sampidevkit/ACIM-Debugger/V0/Production/V0.1/Pic/Top 3.png

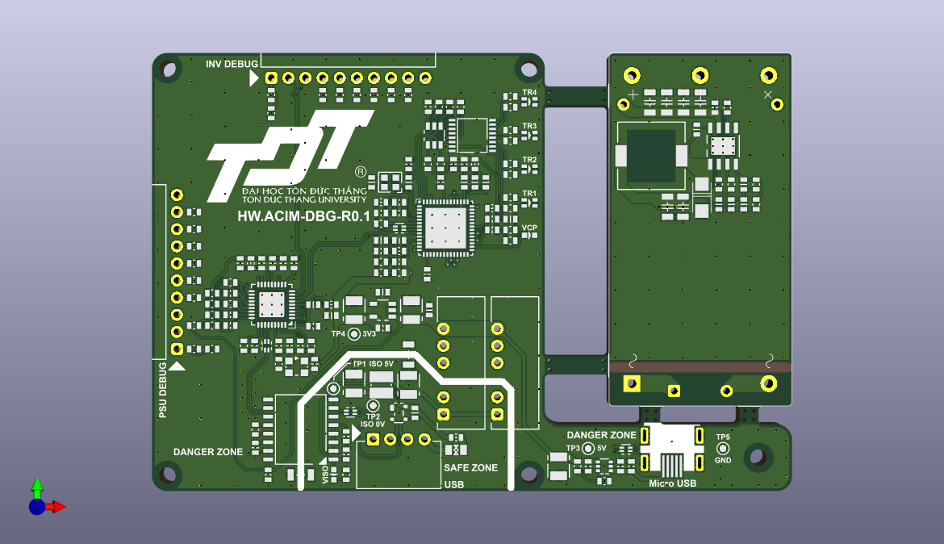
V0/Production/V0.1/Pic/Top 3.png
