sampidevkit/ACIM-Debugger/V0/Production/V0.1/Pic/Top 1.png

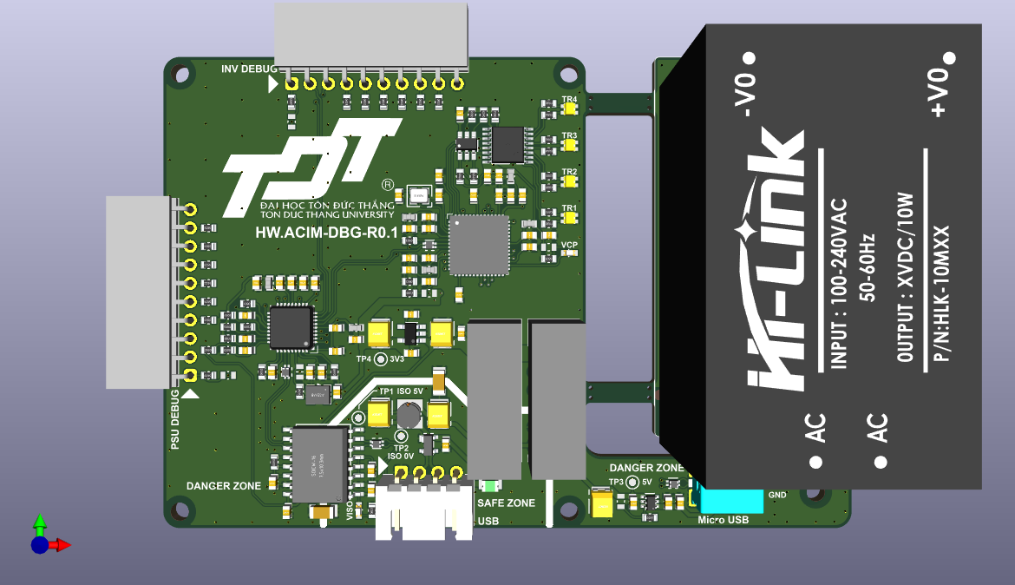
V0/Production/V0.1/Pic/Top 1.png
