sampidevkit/ACIM-Debugger/V0/Docs/RefDocs.md

# REFERENCE DOCUMENTS

1. [DM320106 - PIC32MK GP DEVELOPMENT KIT](https://www.microchip.com/en-us/development-tool/dm320106).

2. [FT4232H - QUAD HIGH SPEED USB TO MULTIPURPOSE UART/MPSSE IC Datasheet](https://ftdichip.com/wp-content/uploads/2020/08/DS_FT4232H.pdf).

3. [ADuM3160 - Full/Low Speed 2.5 kV USB Digital Isolator Datasheet](https://www.analog.com/media/en/technical-documentation/data-sheets/ADuM3160.pdf).

4. [UG-043 - EVAL-ADuM4160EBZ User Guide](https://www.analog.com/media/en/technical-documentation/user-guides/eval-adum4160ebz-ug-043.pdf).

5. [MPLAB Snap In-Circuit Debugger User's Guide](https://ww1.microchip.com/downloads/aemDocuments/documents/DEV/ProductDocuments/UserGuides/50002787C.pdf).

6. [USB251xB/xBi - USB 2.0 Hi-Speed Hub Controller Datasheet](https://ww1.microchip.com/downloads/aemDocuments/documents/UNG/ProductDocuments/DataSheets/USB251xB-xBi-Data-Sheet-DS00001692.pdf).

7. [EV96B94A - WBZ451 Curiosity Board User's Guide](https://ww1.microchip.com/downloads/aemDocuments/documents/WSG/ProductDocuments/UserGuides/WBZ451-Curiosity-Board-User-Guide-DS50003367.pdf).
