sampidevkit/ACIM-Debugger/V0/Production/V0.1/Pic/Bot.png

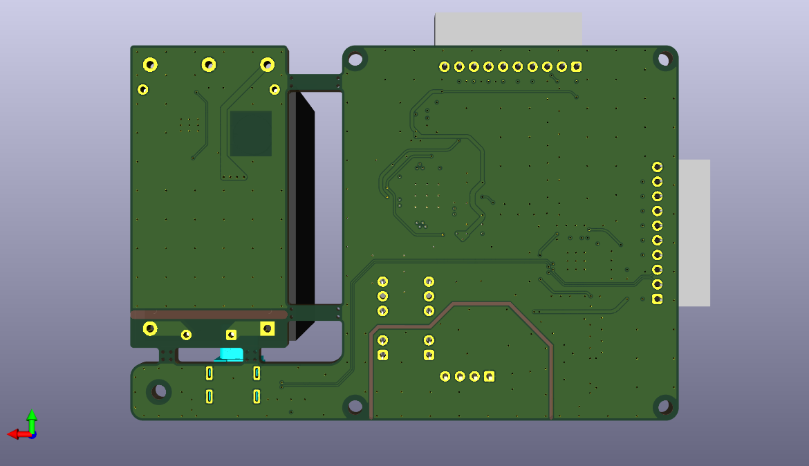
V0/Production/V0.1/Pic/Bot.png
