sampidevkit/ACIM-Debugger/V0/Production/V0.1/BoM/HW.ACIM-DBG.xlsx

# | MNP | MFT | Description | Reference | Qty | Stock Link
33 | ADUM3160BRWZ-RL | Analog | DGT ISOL 2500VRMS 2CH USB 16SOIC | U3 | 1
24 | DMN2310U-7 | Diodes | MOSFET N-CH 20 V 1.6A SOT-23-3 | Q1,Q2 | 2
21 | MCL2012V1-4R7-R | Eaton | FIXED IND 4.7UH 120MA 400MOHM SM | L1 | 1
35 | FT4232H-56Q | FTDI | IC USB TO UART/MPSSE QUAD 56VQFN | U5 | 1
9 | B2612USNG20D000212U1930 | Harvatek | LED GREEN/RED DIFFUSED 0606 SMD | D2 | 1
10 | B2612USNG20D000212U1930 | Harvatek | LED GREEN/RED DIFFUSED 0606 SMD | D3 | 1
11 | B2612USNG20D000212U1930 | Harvatek | LED GREEN/RED DIFFUSED 0606 SMD | D4 | 1
12 | B2612USNG20D000212U1930 | Harvatek | LED GREEN/RED DIFFUSED 0606 SMD | D5 | 1
13 | B1931TW--20P000314U1930 | Harvatek | LED WHITE 0603 SMD | D6 | 1
18 | ZX60-B-5S(31) | Hirose | CONN PLUG USB2.0 MICRO B SMD R/A | J2 | 1
16 | MCM1012B121F06BPDG | INPAQ | CMF 1210 120OHM 300MA 2LN SMD | FT2,FT3,FT6,FT11 | 4
1 | TLJB227M006R0500 | KAVX | CAP TANT 220UF 20% 6.3V 1411 | C1,C2,C7 | 3
14 | 0805L050WR | Littelfuse | PTC RESET FUSE 6V 500MA 0805 | F1 | 1
23 | PG164100 | MCHP | MPLAB SNAP DEBUGGER | MD2 | 1
31 | MIC5504-3.3YM5-TR | MCHP | IC REG LINEAR 3.3V 300MA SOT23-5 | U1 | 1
32 | USB2514B/M2 | MCHP | IC HUB CTLR 4PORT USB 2.0 HS 36S | U2 | 1
34 | DSC1001CE1-024.0000 | MCHP | MEMS OSC XO 24.0000MHZ CMOS SMD | U4 | 1
36 | 93LC56AT-I/OT | MCHP | IC EEPROM 2KBIT MIC WIRE SOT23-6 | U6 | 1
38 | DSC1001CE1-012.0000 | MCHP | MEMS OSC XO 12.0000MHZ CMOS SMD | U8 | 1
22 | B0505MT-1WR4 | Mornsun | DC DC CONVERTER 5V 1W | MD1 | 1
8 | PRTR5V0U2X,215 | Nexperia | TVS DIODE 5.5VWM SOT143B | D1 | 1
37 | 74HC595PW,118 | Nexperia | IC SHIFT REGISTER 8BIT 16TSSOP | U7 | 1
7 | JACK-USBC-4P | OEM | JACK USB TYPE C TO XH4-2.54 | CB1 | 1 | https://nshopvn.com/product/jack-type-c-4-day-co-nap-chong-nuoc/
20 | XH2.54-4P-R | OEM | PIN HEADER R/A 1x4POS 2.54MM | J4 | 1 | https://www.thegioiic.com/dau-xh-2-54mm-4-chan-cong-xuyen-lo
15 | PE-0603PFB121ST | Pulse | FERRITE BEAD 120 OHM 1A 0603 1LN | FT1,FT4,FT5,FT7,FT8,FT9,FT10 | 7
2 | CL10B104KB8NNNC | Samsung | CAP CER 0.1UF 50V X7R 0603 | C3,C4,C8,C11,C12,C15,C17,C19,C21,C22,C33,C35,C37,C39,C42,C45,C48,C49,C50,C51,C52 | 21
4 | CL10A106MQ8NNNC | Samsung | CAP CER 10UF 6.3V X5R 0603 | C9,C10,C13,C16,C26,C36,C40,C43,C46 | 9
17 | PPTC101LGBN-RC | Sullins | CONN HDR 10POS 0.1 TIN PCB R/A | J1 | 1
19 | PPTC101LGBN-RC | Sullins | CONN HDR 10POS 0.1 TIN PCB R/A | J3 | 1
5 | 0603N220J500CT | Walsin | CAP CER 22PF 50V C0G/NP0 0603 | C14,C18,C24,C25,C32,C34,C38,C41,C44,C47 | 10
3 | 885342208022 | WE | CAP CER 100PF 2000V X7R 1206 | C5,C6 | 2
6 | CC0603KRX7R9BB103 | YAGEO | CAP CER 10000PF 50V X7R 0603 | C20,C23,C27,C28,C29,C30,C31,C53 | 8
25 | AC0603FR-071K1L | YAGEO | RES SMD 1.1K OHM 1% 1/10W 0603 | R1,R35,R36,R37,R38,R39,R40,R41,R42 | 9
26 | RC0603JR-070RL | YAGEO | RES 0 OHM JUMPER 1/10W 0603 | R2,R8,R15,R17,R18,R19,R20,R21,R22,R23,R24,R25,R26,R27,R28,R43,R44,R45 | 18
27 | RC0603FR-0710KL | YAGEO | RES 10K OHM 1% 1/10W 0603 | R3,R4,R5,R6,R7,R30,R31,R32,R33,R34 | 10
28 | RC0603FR-0712KL | YAGEO | RES 12K OHM 1% 1/10W 0603 | R9,R29 | 2
29 | RC0603FR-0747KL | YAGEO | RES 47K OHM 1% 1/10W 0603 | R10,R11,R12 | 3
30 | RC0603FR-07100KL | YAGEO | RES 100K OHM 1% 1/10W 0603 | R13,R14,R16 | 3
