sampidevkit/ACIM-Debugger/V0/Production/V0.1/Sch/HW.ACIM-DBG.pdf

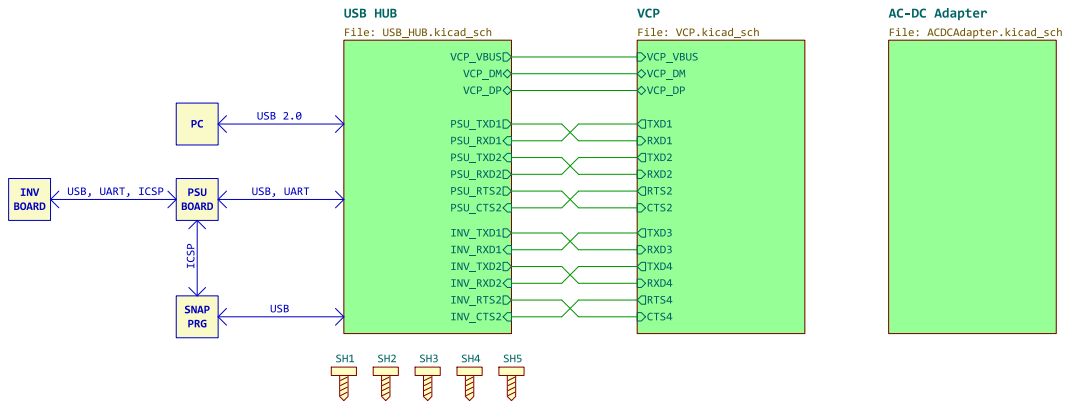
[picture p4: page 1]

Schematic Designed by ... PCB Designed by ... Approved by ...

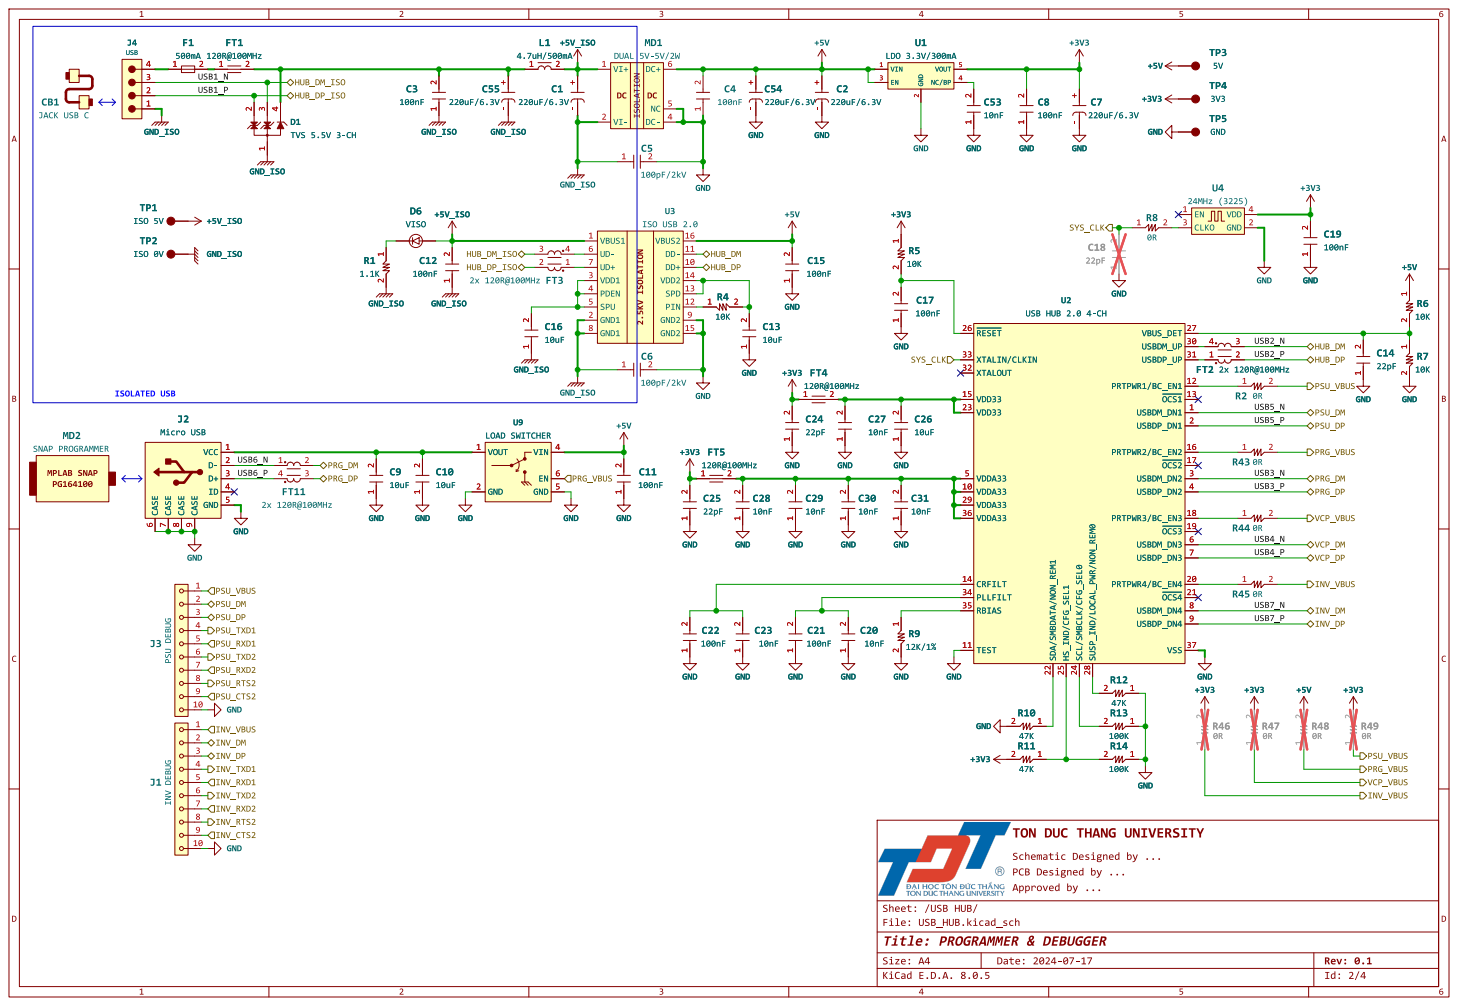
[picture p5: page 2]

2 EN 3 NC/BP 4 VOUT 5 U1
LDO3.3V/300mA

2 EN 3 NC/BP 4 VOUT 5 GND C54

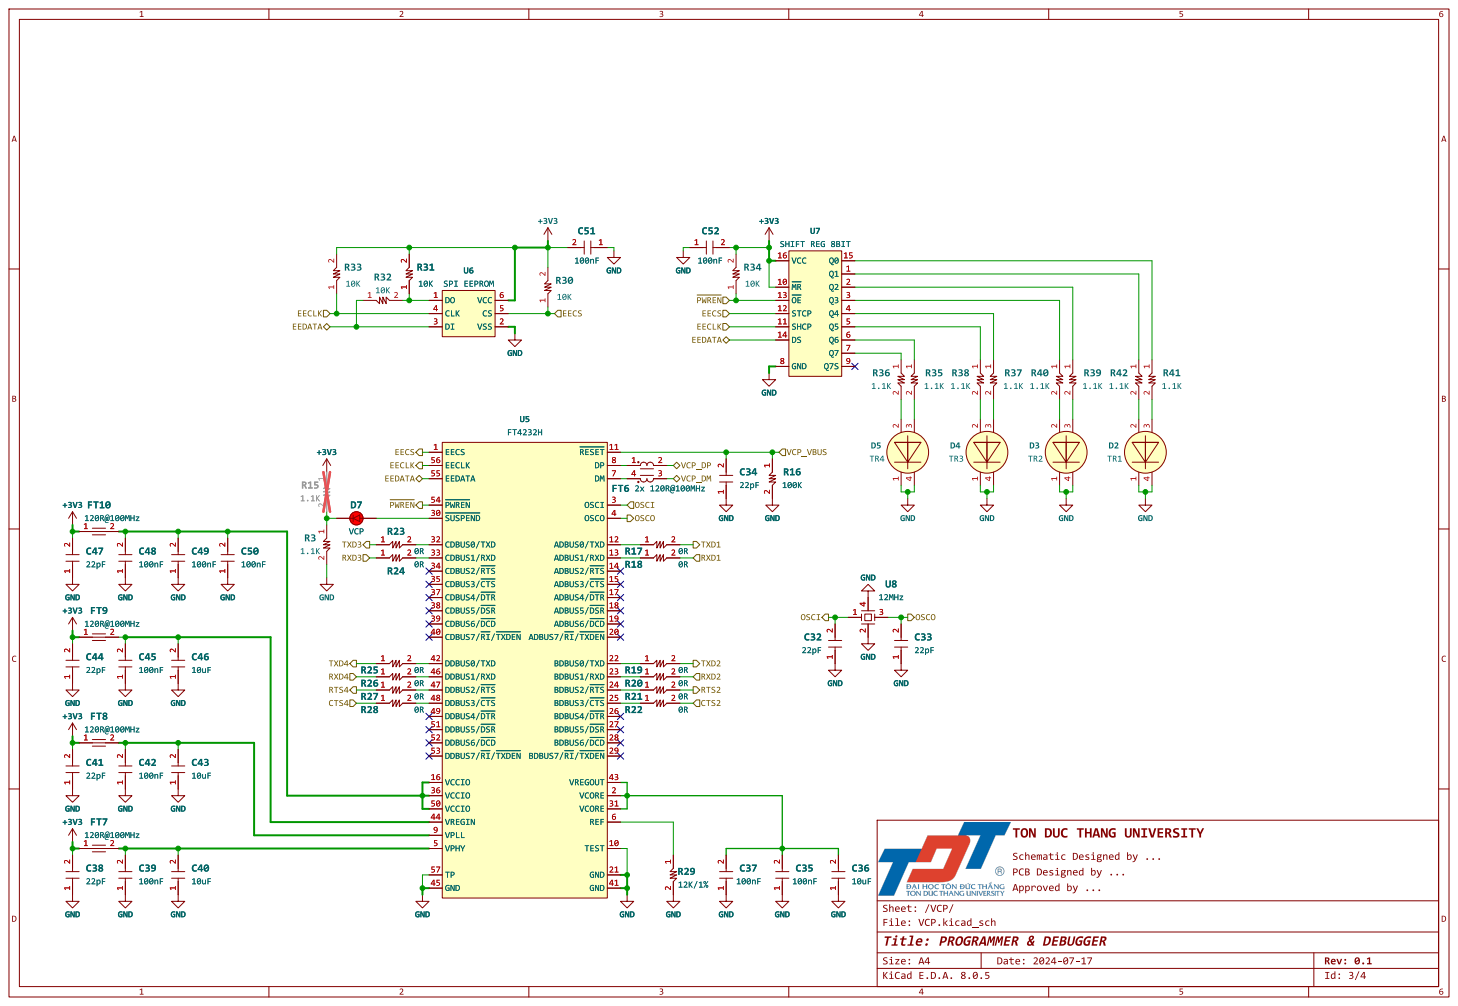
[picture p6: page 3]

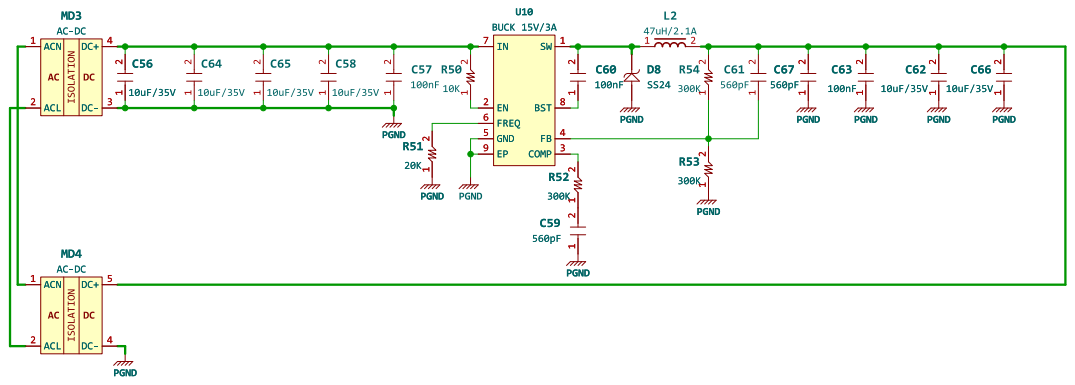
[picture p7: page 4]

Schematic Designed by ... PCB Designed by ... Approved by ...
