sampidevkit/ACIM-Debugger/V0/Production/V0.0/Sch/HW.ACIM-DBG.pdf

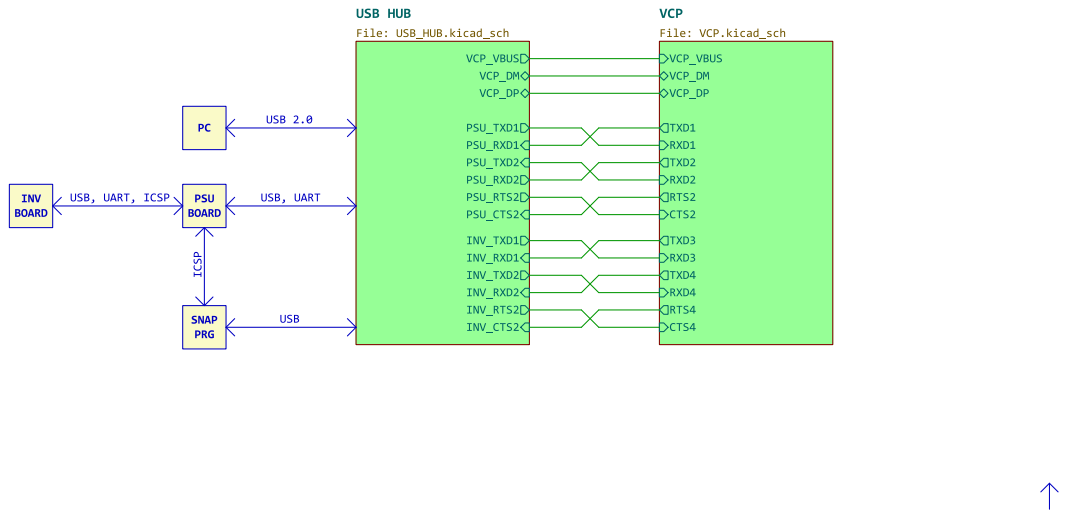
[picture p8: page 1]

Schematic Designed by ... PCB Designed by ... Approved by ...

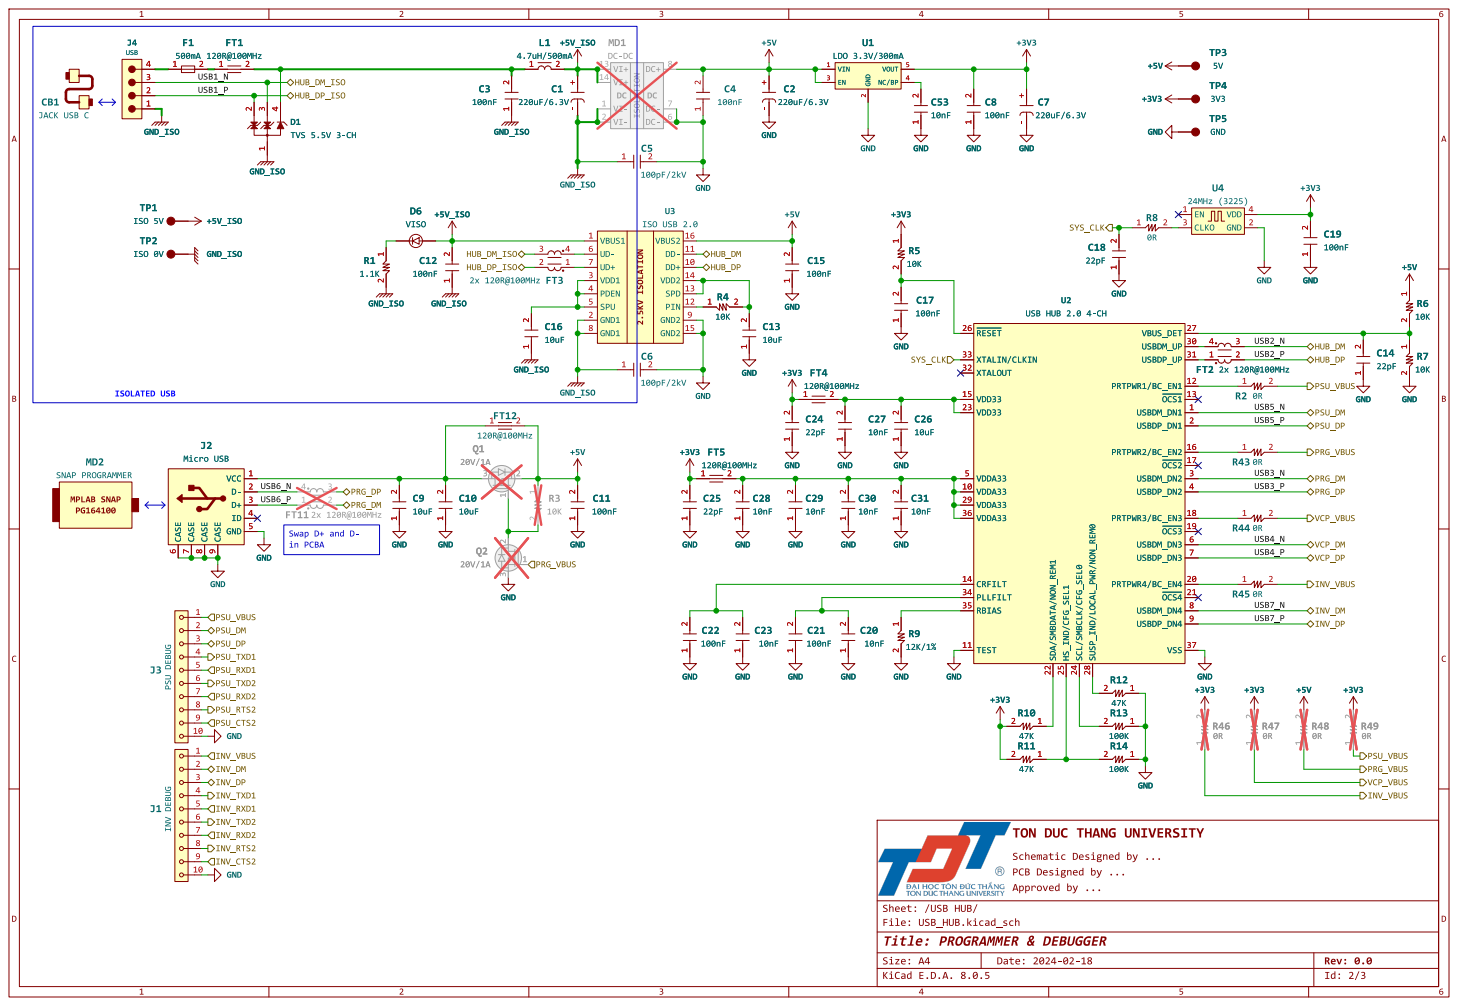
[picture p9: page 2]

2 EN 3 NC/BP 4 VOUT 5 U1
LDO3.3V/300mA GND

2 EN 3 NC/BP 4 VOUT 5R5

Schematic Designed by ... PCB Designed by ... Approved by ...

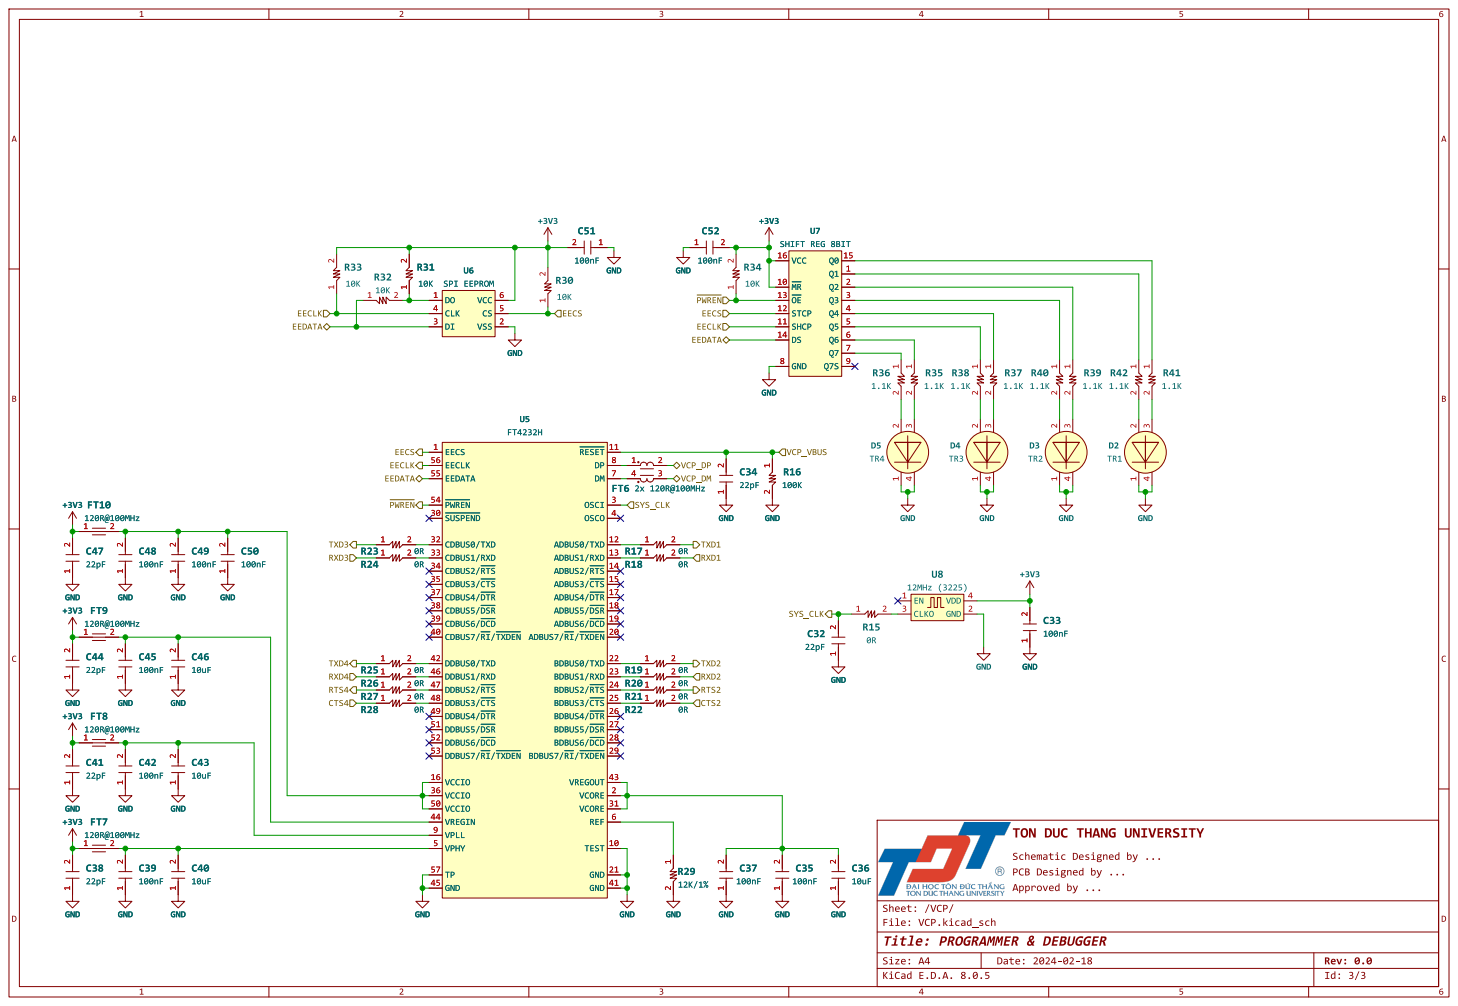
[picture p10: page 3]

3 4 D3 TR2 EN 1 GND 2 CLKO 3 VDD 4 U8
