sampidevkit/ACIM-Debugger/V0/Design/HW.ACIM-DBG/ACDCAdapter.kicad_sch

## KiCad design V0/Design/HW.ACIM-DBG/ACDCAdapter.kicad_sch (2024-09-26)

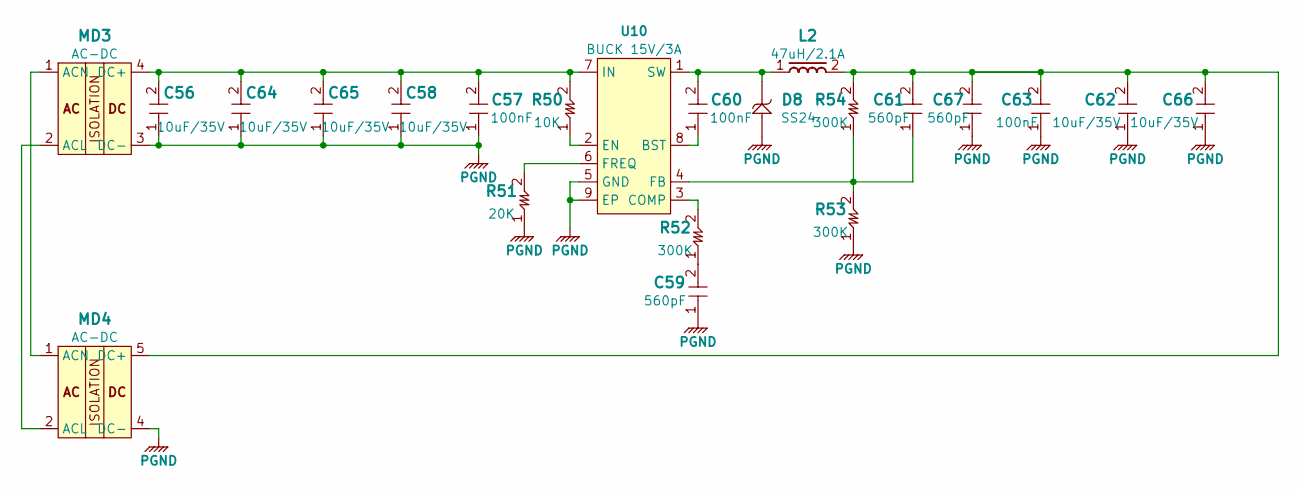
[picture p11: schematic ACDCAdapter.kicad_sch]

Parts:
C56, C58, C62, C64, C65, C66: 10uF/35V; CAP1206
C57, C60, C63: 100nF; CAP0603
C59, C61, C67: 560pF; CAP0603
D8: SS24; DO-214AC
L2: 47uH/2.1A; IND-10x10x3.8
MD3: AC-DC; HLK-10M
MD4: AC-DC; LD10-23BxxR2-RC
R50: 10K; RES0603
R51: 20K; RES0603
R52, R53, R54: 300K; RES0603
U10: BUCK 15V/3A; SOIC8E_3.9_MPS

Connections:
unnamed: C56.2, C57.2, C58.2, C64.2, C65.2, MD3.4 (DC+), R50.2, U10.7 (IN)
unnamed: C59.2, R52.1
unnamed: C60.1, U10.8 (BST)
unnamed: C60.2, D8.K, L2.1, U10.1 (SW)
unnamed: C61.1, R53.2, R54.1, U10.4 (FB)
unnamed: C61.2, C62.2, C63.2, C66.2, C67.2, L2.2, MD4.5 (DC+), R54.2
unnamed: MD3.1 (ACN), MD4.1 (ACN)
unnamed: MD3.2 (ACL), MD4.2 (ACL)
unnamed: R50.1, U10.2 (EN)
unnamed: R51.2, U10.6 (FREQ)
unnamed: R52.2, U10.3 (COMP)
PGND: C56.1, C57.1, C58.1, C59.1, C62.1, C63.1, C64.1, C65.1, C66.1, C67.1, D8.A, MD3.3 (DC-), MD4.4 (DC-), R51.1, R53.1, U10.5 (GND), U10.9 (EP)
