sampidevkit/ACIM-Debugger/V0/Design/HW.ACIM-DBG/HW.ACIM-DBG.kicad_sch

## KiCad design V0/Design/HW.ACIM-DBG/HW.ACIM-DBG.kicad_sch (2024-09-26)

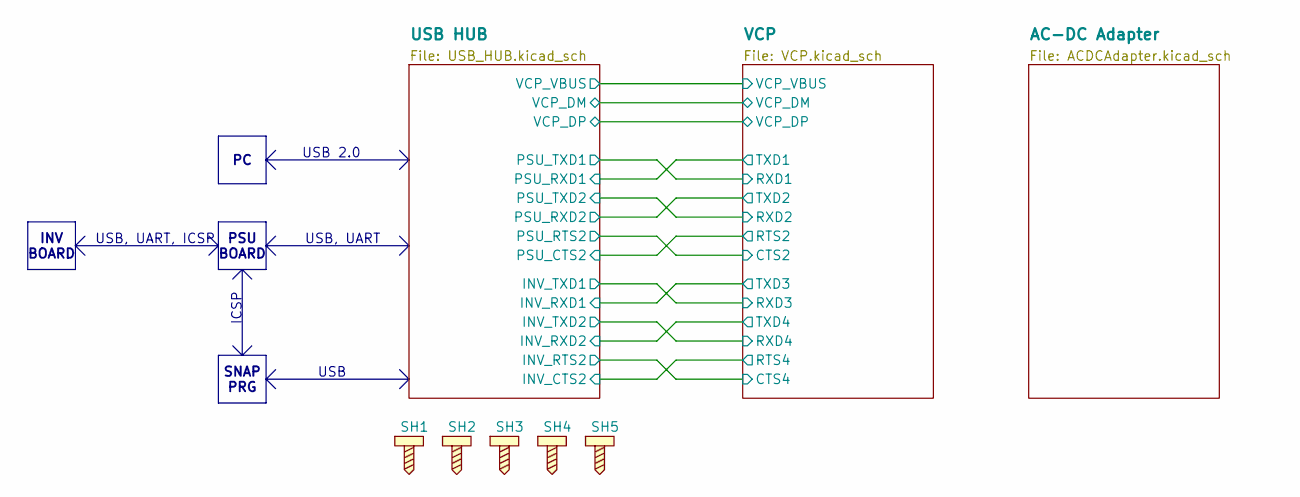
[picture p12: schematic HW.ACIM-DBG.kicad_sch]

Parts:
SH1, SH2, SH3, SH4, SH5: SCREW HOLDER; SCREWHOLE-2.5M

Notes on the sheet:
SNAP PRG
PSU BOARD
INV BOARD
USB
ICSP
USB, UART
USB, UART, ICSP
USB 2.0
