sampidevkit/ACIM-Debugger/V0/Design/HW.ACIM-DBG/USB_HUB.kicad_sch

## KiCad design V0/Design/HW.ACIM-DBG/USB_HUB.kicad_sch (2024-09-26)

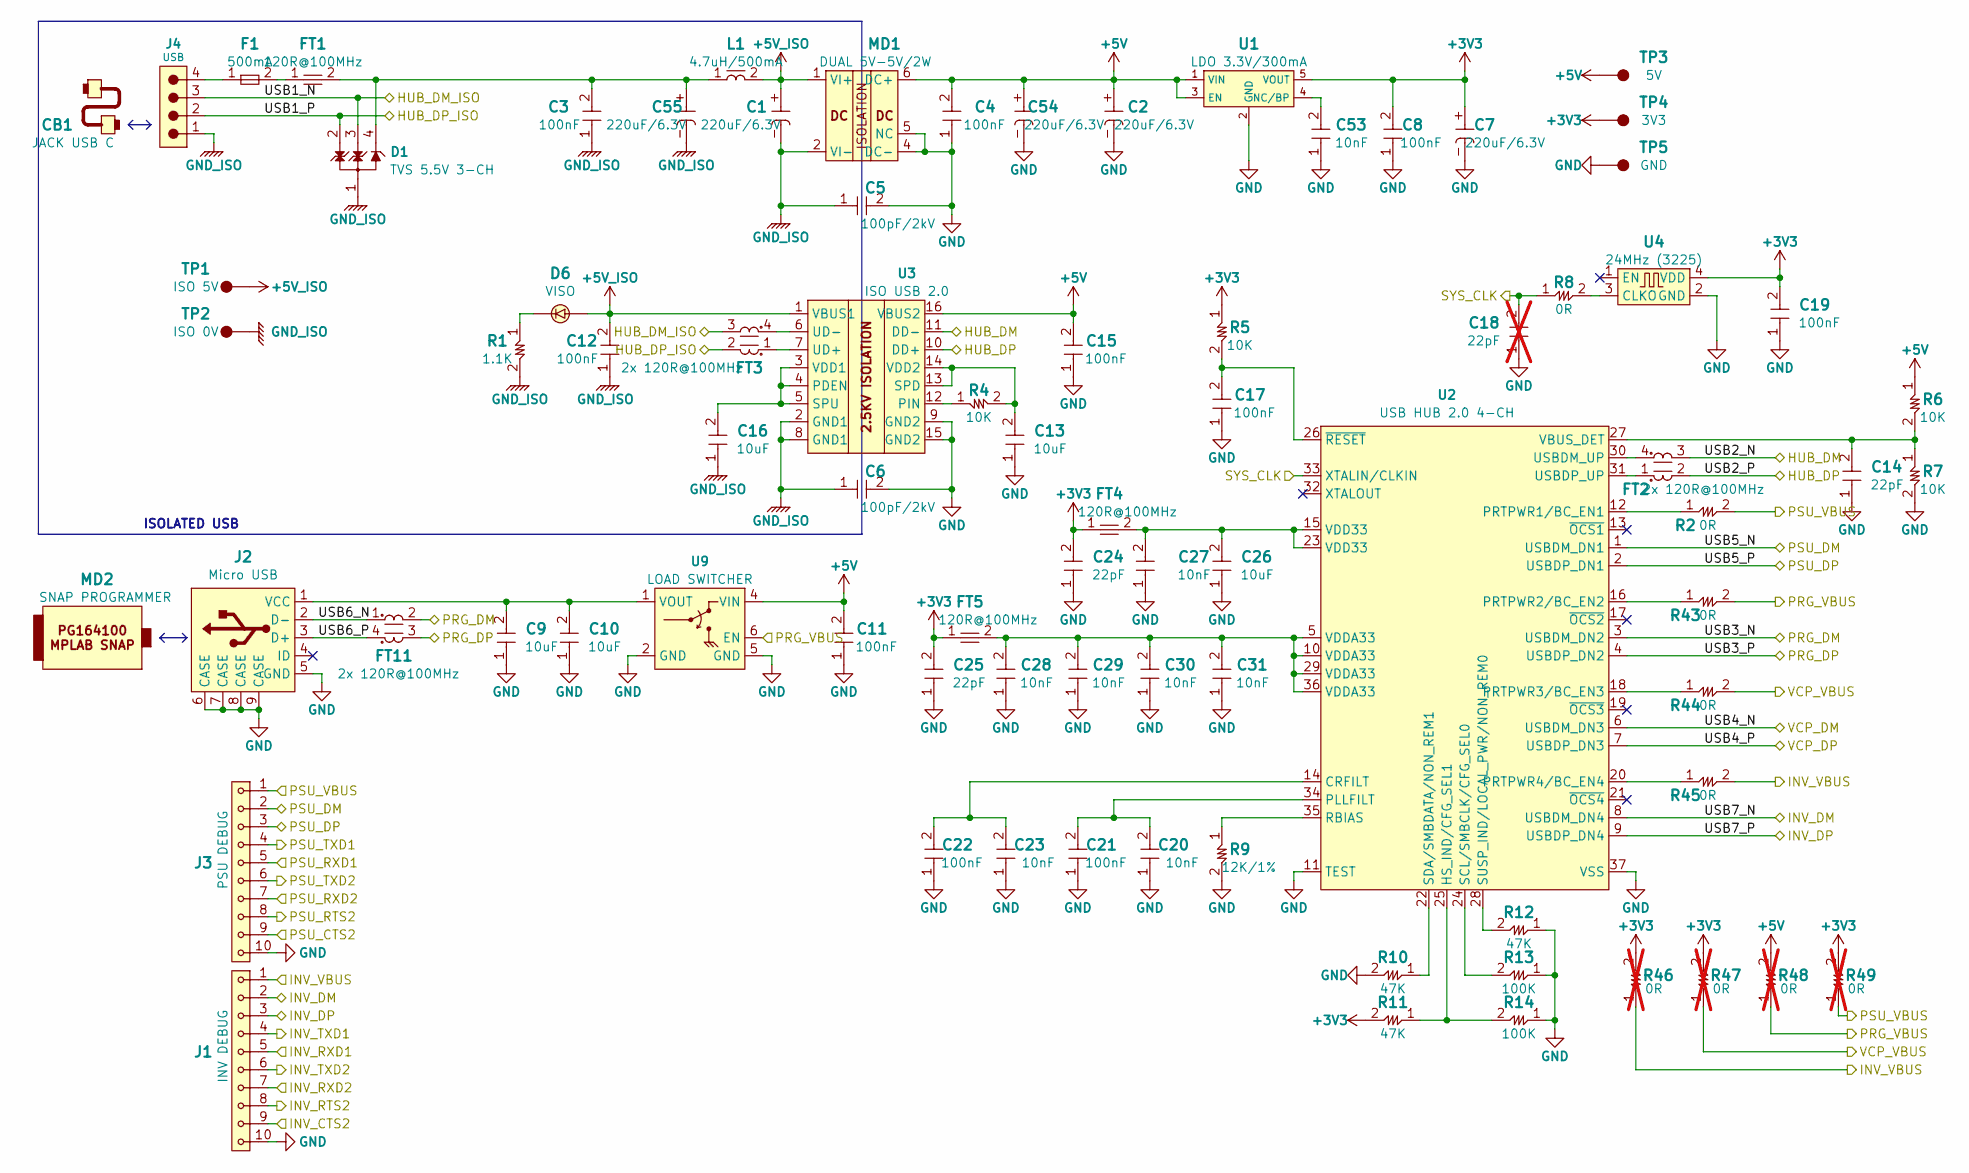
[picture p13: schematic USB_HUB.kicad_sch]

Parts:
C1, C2, C7, C54, C55: 220uF/6.3V; CAP1411
C3, C4, C8, C11, C12, C15, C17, C19, C21, C22: 100nF; CAP0603
C5, C6: 100pF/2kV; CAP1206
C9, C10, C13, C16, C26: 10uF; CAP0603
C14, C24, C25: 22pF; CAP0603
C18: 22pF; CAP0603; not fitted
C20, C23, C27, C28, C29, C30, C31, C53: 10nF; CAP0603
CB1: JACK USB C
D1: TVS 5.5V 3-CH; SOT143B_NEXT
D6: VISO; LED0603
F1: 500mA; FUSE0805
FT1, FT4, FT5: 120R@100MHz; FT0603
FT2, FT3, FT11: 2x 120R@100MHz; IND1210_4P
J1: INV DEBUG; HDF1x10x2.54_TH_RA
J2: Micro USB; ZX60-B-5S(31)
J3: PSU DEBUG; HDF1x10x2.54_TH_RA
J4: USB; HDM-1x4x2.54-TH-RA
L1: 4.7uH/500mA; IND3521
MD1: DUAL 5V-5V/2W; B0505S-2WR2-DUAL
MD2: SNAP PROGRAMMER
R1: 1.1K; RES0603
R2, R8, R43, R44, R45: 0R; RES0603
R4, R5, R6, R7: 10K; RES0603
R9: 12K/1%; RES0603
R10, R11, R12: 47K; RES0603
R13, R14: 100K; RES0603
R46, R47, R48, R49: 0R; RES0603; not fitted
TP1: ISO 5V; TP1MM
TP2: ISO 0V; TP1MM
TP3: 5V; TP1MM
TP4: 3V3; TP1MM
TP5: GND; TP1MM
U1: LDO 3.3V/300mA; SOT-23-5_MCHP
U2: USB HUB 2.0 4-CH; SQFN36_6x6_MCHP
U3: ISO USB 2.0; SOIC16_7.5_AN
U4: 24MHz (3225); CDFN3225-4LD-PL-1
U9: LOAD SWITCHER; SOT363

Connections:
+3V3: C7.+, C8.2, C19.2, C24.2, C25.2, FT4.1, FT5.1, R5.1, R11.2, R46.2, R47.2, R49.2, TP4.1, U1.5 (VOUT), U4.4 (VDD)
+5V: C2.+, C4.2, C11.2, C15.2, C54.+, MD1.6 (DC+), R6.1, R48.2, TP3.1, U1.1 (VIN), U1.3 (EN), U3.16 (VBUS2), U9.4 (VIN)
+5V_ISO: C1.+, C12.2, D6.A, L1.2, MD1.1 (VI+), TP1.1, U3.1 (VBUS1)
GND: C2.-, C4.1, C5.2, C6.2, C7.-, C8.1, C9.1, C10.1, C11.1, C13.1, C14.1, C15.1, C17.1, C18.1, C19.1, C20.1, C21.1, C22.1, C23.1, C24.1, C25.1, C26.1, C27.1, C28.1, C29.1, C30.1, C31.1, C53.1, C54.-, J1.10, J2.5 (GND), J2.6 (CASE), J2.7 (CASE), J2.8 (CASE), J2.9 (CASE), J3.10, MD1.4 (DC-), MD1.5 (NC), R7.2, R9.2, R10.2, R12.1, R13.1, R14.1, TP5.1, U1.2 (GND), U2.11 (TEST), U2.37 (VSS), U3.9 (GND2), U3.15 (GND2), U4.2 (GND), U9.2 (GND), U9.5 (GND)
GND_ISO: C1.-, C3.1, C5.1, C6.1, C12.1, C16.1, C55.-, D1.1 (GND), J4.1, MD1.2 (VI-), R1.2, TP2.1, U3.2 (GND1), U3.8 (GND1)
HUB_DM: FT2.3, U3.11 (DD-)
HUB_DM_ISO: D1.3 (CH2), FT3.3, J4.3
HUB_DP: FT2.2, U3.10 (DD+)
HUB_DP_ISO: D1.2 (CH1), FT3.2, J4.2
INV_CTS2: J1.9
INV_DM: J1.2, U2.8 (USBDM_DN4)
INV_DP: J1.3, U2.9 (USBDP_DN4)
INV_RTS2: J1.8
INV_RXD1: J1.5
INV_RXD2: J1.7
INV_TXD1: J1.4
INV_TXD2: J1.6
INV_VBUS: J1.1, R45.2, R46.1
unnamed: C3.2, C55.+, D1.4 (CH3), FT1.2, L1.1
unnamed: C9.2, C10.2, J2.1 (VCC), U9.1 (VOUT)
unnamed: C13.2, R4.2, U3.13 (SPD), U3.14 (VDD2)
unnamed: C14.2, R6.2, R7.1, U2.27 (VBUS_DET)
unnamed: C16.2, U3.3 (VDD1), U3.4 (PDEN), U3.5 (SPU)
unnamed: C17.2, R5.2, U2.26 (~RESET)
unnamed: C20.2, C21.2, U2.34 (PLLFILT)
unnamed: C22.2, C23.2, U2.14 (CRFILT)
unnamed: C26.2, C27.2, FT4.2, U2.15 (VDD33), U2.23 (VDD33)
unnamed: C28.2, C29.2, C30.2, C31.2, FT5.2, U2.5 (VDDA33), U2.10 (VDDA33), U2.29 (VDDA33), U2.36 (VDDA33)
unnamed: C53.2, U1.4 (NC/BP)
unnamed: D6.K, R1.1
unnamed: F1.1, J4.4
unnamed: F1.2, FT1.1
unnamed: FT2.1, U2.31 (USBDP_UP)
unnamed: FT2.4, U2.30 (USBDM_UP)
unnamed: FT3.1, U3.7 (UD+)
unnamed: FT3.4, U3.6 (UD-)
unnamed: R2.1, U2.12 (PRTPWR1/BC_EN1)
unnamed: R4.1, U3.12 (PIN)
unnamed: R8.2, U4.3 (CLKO)
unnamed: R9.1, U2.35 (RBIAS)
unnamed: R10.1, U2.22 (SDA/SMBDATA/NON_REM1)
unnamed: R11.1, R14.2, U2.25 (HS_IND/CFG_SEL1)
unnamed: R12.2, U2.28 (SUSP_IND/LOCAL_PWR/NON_REM0)
unnamed: R13.2, U2.24 (SCL/SMBCLK/CFG_SEL0)
unnamed: R43.1, U2.16 (PRTPWR2/BC_EN2)
unnamed: R44.1, U2.18 (PRTPWR3/BC_EN3)
unnamed: R45.1, U2.20 (PRTPWR4/BC_EN4)
PRG_DM: FT11.2, U2.3 (USBDM_DN2)
PRG_DP: FT11.3, U2.4 (USBDP_DN2)
PRG_VBUS: R43.2, R48.1, U9.6 (EN)
PSU_CTS2: J3.9
PSU_DM: J3.2, U2.1 (USBDM_DN1)
PSU_DP: J3.3, U2.2 (USBDP_DN1)
PSU_RTS2: J3.8
PSU_RXD1: J3.5
PSU_RXD2: J3.7
PSU_TXD1: J3.4
PSU_TXD2: J3.6
PSU_VBUS: J3.1, R2.2, R49.1
SYS_CLK: C18.2, R8.1, U2.33 (XTALIN/CLKIN)
USB4_N: U2.6 (USBDM_DN3)
USB4_P: U2.7 (USBDP_DN3)
USB6_N: FT11.1, J2.2 (D-)
USB6_P: FT11.4, J2.3 (D+)
VCP_VBUS: R44.2, R47.1

Notes on the sheet:
ISOLATED USB
