sampidevkit/ACIM-Debugger/V0/Design/HW.ACIM-DBG/VCP.kicad_sch

## KiCad design V0/Design/HW.ACIM-DBG/VCP.kicad_sch (2024-09-26)

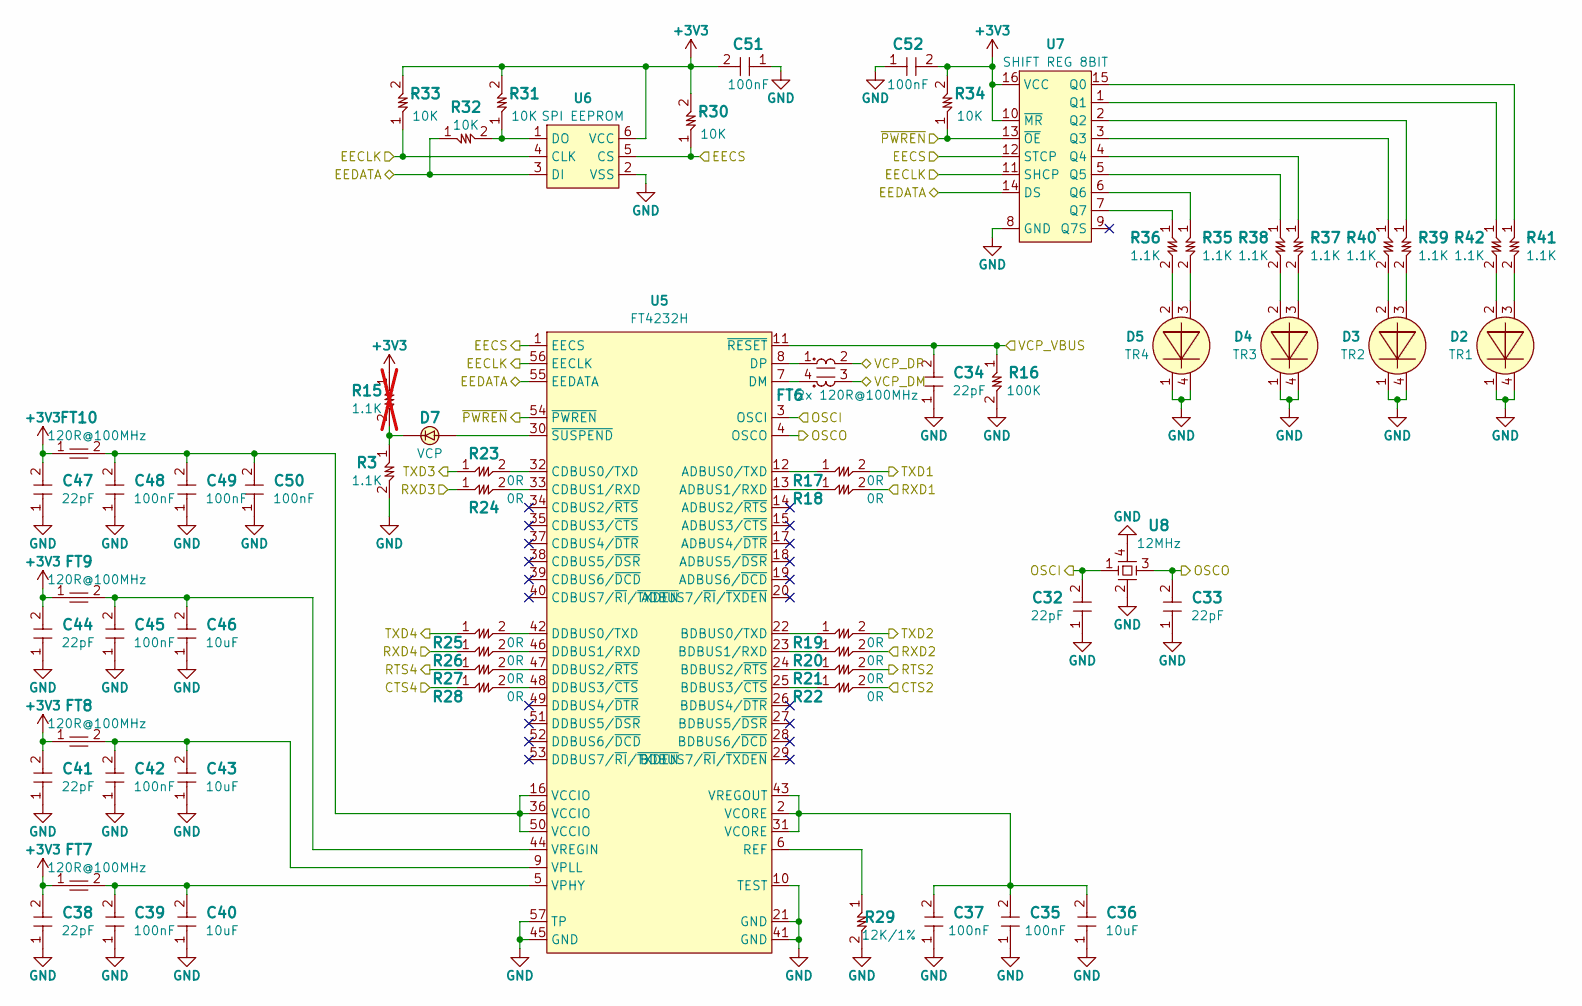
[picture p14: schematic VCP.kicad_sch]

Parts:
C32, C33, C34, C38, C41, C44, C47: 22pF; CAP0603
C35, C37, C39, C42, C45, C48, C49, C50, C51, C52: 100nF; CAP0603
C36, C40, C43, C46: 10uF; CAP0603
D2: TR1; LED0606_4P
D3: TR2; LED0606_4P
D4: TR3; LED0606_4P
D5: TR4; LED0606_4P
D7: VCP; LED0603
FT6: 2x 120R@100MHz; IND1210_4P
FT7, FT8, FT9, FT10: 120R@100MHz; FT0603
R3, R35, R36, R37, R38, R39, R40, R41, R42: 1.1K; RES0603
R15: 1.1K; RES0603; not fitted
R16: 100K; RES0603
R17, R18, R19, R20, R21, R22, R23, R24, R25, R26, R27, R28: 0R; RES0603
R29: 12K/1%; RES0603
R30, R31, R32, R33, R34: 10K; RES0603
U5: FT4232H; VQFN-56_FTDI
U6: SPI EEPROM; SOT-23-6_MCHP
U7: SHIFT REG 8BIT; TSSOP16-SOT403-1
U8: 12MHz; CDFN2520-ABM10

Connections:
+3V3: C38.2, C41.2, C44.2, C47.2, C51.2, C52.2, FT7.1, FT8.1, FT9.1, FT10.1, R15.1, R30.2, R31.2, R33.2, R34.2, U6.6 (VCC), U7.10 (~MR), U7.16 (VCC)
CTS2: R22.2
CTS4: R28.1
EECLK: R33.1, U5.56 (EECLK), U6.4 (CLK), U7.11 (SHCP)
EECS: R30.1, U5.1 (EECS), U6.5 (CS), U7.12 (STCP)
EEDATA: R32.1, U5.55 (EEDATA), U6.3 (DI), U7.14 (DS)
GND: C32.1, C33.1, C34.1, C35.1, C36.1, C37.1, C38.1, C39.1, C40.1, C41.1, C42.1, C43.1, C44.1, C45.1, C46.1, C47.1, C48.1, C49.1, C50.1, C51.1, C52.1, D2.1 (GK), D2.4 (RK), D3.1 (GK), D3.4 (RK), D4.1 (GK), D4.4 (RK), D5.1 (GK), D5.4 (RK), R3.2, R16.2, R29.2, U5.10 (TEST), U5.21 (GND), U5.41 (GND), U5.45 (GND), U5.57 (TP), U6.2 (VSS), U7.8 (GND), U8.2 (GND1), U8.4 (X2)
unnamed: C35.2, C36.2, C37.2, U5.2 (VCORE), U5.31 (VCORE), U5.43 (VREGOUT)
unnamed: C39.2, C40.2, FT7.2, U5.5 (VPHY)
unnamed: C42.2, C43.2, FT8.2, U5.9 (VPLL)
unnamed: C45.2, C46.2, FT9.2, U5.44 (VREGIN)
unnamed: C48.2, C49.2, C50.2, FT10.2, U5.16 (VCCIO), U5.36 (VCCIO), U5.50 (VCCIO)
unnamed: D2.2 (GA), R42.2
unnamed: D2.3 (RA), R41.2
unnamed: D3.2 (GA), R40.2
unnamed: D3.3 (RA), R39.2
unnamed: D4.2 (GA), R38.2
unnamed: D4.3 (RA), R37.2
unnamed: D5.2 (GA), R36.2
unnamed: D5.3 (RA), R35.2
unnamed: D7.A, U5.30 (~SUSPEND)
unnamed: D7.K, R3.1, R15.2
unnamed: FT6.1, U5.8 (DP)
unnamed: FT6.4, U5.7 (DM)
unnamed: R17.1, U5.12 (ADBUS0/TXD)
unnamed: R18.1, U5.13 (ADBUS1/RXD)
unnamed: R19.1, U5.22 (BDBUS0/TXD)
unnamed: R20.1, U5.23 (BDBUS1/RXD)
unnamed: R21.1, U5.24 (BDBUS2/~RTS)
unnamed: R22.1, U5.25 (BDBUS3/~CTS)
unnamed: R23.2, U5.32 (CDBUS0/TXD)
unnamed: R24.2, U5.33 (CDBUS1/RXD)
unnamed: R25.2, U5.42 (DDBUS0/TXD)
unnamed: R26.2, U5.46 (DDBUS1/RXD)
unnamed: R27.2, U5.47 (DDBUS2/~RTS)
unnamed: R28.2, U5.48 (DDBUS3/~CTS)
unnamed: R29.1, U5.6 (REF)
unnamed: R31.1, R32.2, U6.1 (DO)
unnamed: R35.1, U7.6 (Q6)
unnamed: R36.1, U7.7 (Q7)
unnamed: R37.1, U7.4 (Q4)
unnamed: R38.1, U7.5 (Q5)
unnamed: R39.1, U7.2 (Q2)
unnamed: R40.1, U7.3 (Q3)
unnamed: R41.1, U7.15 (Q0)
unnamed: R42.1, U7.1 (Q1)
OSCI: C32.2, U5.3 (OSCI), U8.1 (X1)
OSCO: C33.2, U5.4 (OSCO), U8.3 (GND2)
RTS2: R21.2
RTS4: R27.1
RXD1: R18.2
RXD2: R20.2
RXD3: R24.1
RXD4: R26.1
TXD1: R17.2
TXD2: R19.2
TXD3: R23.1
TXD4: R25.1
VCP_DM: FT6.3
VCP_DP: FT6.2
VCP_VBUS: C34.2, R16.1, U5.11 (~RESET)
~PWREN: R34.1, U5.54 (~PWREN), U7.13 (~OE)
