sampidevkit/ACIM-Debugger/(commit log)

2024-09-25 V0 production files
    [HW.ACIM-DBG-B_Cu.gbr, HW.ACIM-DBG-B_Mask.gbr, HW.ACIM-DBG-B_Paste.gbr, HW.ACIM-DBG-B_Silkscreen.gbr, HW.ACIM-DBG-Edge_Cuts.gbr, HW.ACIM-DBG-F_Cu.gbr, HW.ACIM-DBG-F_Mask.gbr, HW.ACIM-DBG-F_Paste.gbr]
2024-09-26 V0.1 production files
    [ACDCAdapter.kicad_sch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]
